Freshdouble/RFM23_Module/Coordinate.png

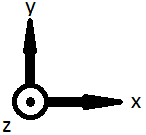
Coordinate.png
