Freshdouble/RFM23_Module/BR_BOM_Selection.xlsx

Part | Value | Package | Qty | Place_YES/NO | Povided_by_customer_YES/NO | Distributor | Ordernumber | Remarks_customer | Unit_price | Total_price | REMARKS_BETA
AE1 AE2 |  | SMA_THT | 2 | NO | YES
C10 C11 C12 C5 C6 C20 C41 C19 C31 C32 C33 C26 C27 C22 C42 C40 | 100nF | 0603 | 16 | YES | NO | Digikey | 399-7845-1-ND
C14 C13 C15 C35 C34 C36 | 47µF | 1210 | 6 | YES | NO | Digikey | 490-6538-1-ND
C16 C37 | 47pF | 0603 | 2 | YES | NO | Digikey | 399-6191-1-ND
C17 C38 | 680pF | 0603 | 2 | YES | NO | Digikey | 399-7948-1-ND
C18 C39 | 12pF | 0603 | 2 | YES | NO | Digikey | 712-1313-1-ND
C2 C23 | 1µF | 1210 | 2 | YES | NO | Digikey | 587-1366-1-ND
C3 C24 | 1nF | 0603 | 2 | YES | NO | Digikey | 478-1215-1-ND
C4 C1 C25 C21 | 10µF | 1210 | 4 | YES | NO | Digikey | 490-1875-1-ND
C7 C8 C28 C29 | 15pF | 0603 | 4 | YES | NO | Digikey | 478-6024-1-ND
C9 C30 | 10nF | 0603 | 2 | YES | NO | Digikey | 478-1227-1-ND
CON11 CON21 | FTS-130-03-L-DV-SA | FTS-130-03-L-DV-SA | 2 | YES | NO | Digikey | FTS-130-03-L-DV-SA-ND | Place on Toplayer
CON11 CON21 | CLP-130-02-F-D-A | CLP-130-02-F-D-A | 2 | YES | NO | Digikey | CLP-130-02-F-D-A-ND | Place on Bottomlayer
D10 D28 | DZ2J036M0L | SOD-323F | 2 | YES | NO | Digikey | DZ2J036M0LCT-ND
D11 D12 D13 D14 D15 D16 D17 D18 D33 | SMF3.3 | SOD-123F | 9 | NO | YES | Digikey | F7701CT-ND
D9 D4 D1 D2 D6 D3 D5 D8 D7 D30 D29 D27 D22 D19 D20 D24 D21 D23 D26 D25 D32 D31 | TS4148C RZG | 0603 | 22 | YES | NO | Digikey | TS4148C RZGCT-ND
L1 L3 | 10nH | 0603 | 2 | YES | NO | Digikey | 1276-6306-1-ND
L2 L4 | 5µH | L_6.3x6.3_H3 | 2 | YES | NO | Digikey | 308-2073-2-ND
Q1 Q9 | SSM3J334R,LF | SOT-23 | 2 | NO | NO | Digikey | SSM3J334RLFTR-ND
Q2 Q17 Q10 Q18 | AO3414 | SOT-23 | 4 | YES | NO | Digikey | 785-1009-1-ND
Q6 Q7 Q3 Q4 Q5 Q8 Q14 Q15 Q11 Q12 Q13 Q16 | MMBT5551-TP | SOT-23 | 12 | YES | NO | Digikey | MMBT5551-TPTR-ND
R1 R46 | 22k | 0603 | 2 | YES | NO | Digikey | RMCF0603JT22K0CT-ND
R10 R55 | 15k | 0603 | 2 | YES | NO | Digikey | RMCF0603JT15K0CT-ND
R14 R11 R6 R2 R9 R3 R7 R92 R59 R56 R51 R47 R54 R48 R52 R96 | 100k | 0603 | 16 | YES | NO | Digikey | 311-100KLDCT-ND
R15 R16 | 0R | 0805 | 2 | NO | YES
R18 R5 R91 R63 R50 R95 | 100R | 0603 | 6 | YES | NO | Digikey | RMCF0603JT100RCT-ND
R20 R26 R27 R28 R29 R30 R45 R76 R71 R72 R73 R74 R75 R77 | 4k7 | 0603 | 14 | YES | NO | Digikey | 311-4.7KGRCT-ND
R36 R84 | 90k9 | 0603 | 2 | YES | NO | Digikey | P90.9KHCT-ND
R37 R85 | 49k9 | 0603 | 2 | YES | NO | Digikey | RMCF0603FT49K9CT-ND
R38 R86 | 6k81 | 0603 | 2 | YES | NO | Digikey | RMCF0603FT6K81CT-ND
R39 R87 | 121k | 0603 | 2 | YES | NO | Digikey | 311-2410-1-ND
R4 R49 | 47R | 0603 | 2 | YES | NO | Digikey | RMCF0603JT47R0CT-ND
R40 R88 | 887k | 0603 | 2 | YES | NO | Digikey | P16016CT-ND
R43 R83 | 0R | 0603 | 2 | YES | NO | Digikey | P0.0GCT-ND
R8 R12 R13 R93 R94 R19 R21 R22 R23 R24 R25 R31 R32 R33 R34 R35 R42 R41 R44 R53 R57 R58 R97 R98 R69 R64 R65 R66 R67 R68 R78 R79 R80 R81 R82 R90 R89 R70 | 10k | 0603 | 38 | YES | NO | Digikey | RMCF0603JT10K0CT-ND
U1 U6 | MC74HC4538ADR2G | SOIC16 | 2 | YES | NO | Digikey | MC74HC4538ADR2GOSCT-ND
U2 U7 | MAX892LEUA+ | µMax8 | 2 | YES | NO | Digikey | MAX892LEUA+-ND
U3 U8 | ATMEGA128-16AURCT-ND | TQFP64 | 2 | YES | NO | Digikey | ATMEGA128-16AURCT-ND
U4 U9 | LTC3113IFE#PBF | TSSOP 20 | 2 | YES | NO | Digikey | LTC3113IFE#PBF-ND
U5 U10 |  | RFM23BP | 2 | NO | YES
Y1 Y2 |  | Crystal_SMD_7050-4pin_7.0x5.0mm | 2 | YES | NO | Digikey | 535-9825-1-ND
