Freshdouble/RFM23_Module/cubesatFunkmodul-all.ods

name | X-axis | Y-axis | angle | value | package | side
FID1 | 69.7995 | -107.6115 | 0.0000 | Fiducial | Fiducial_0.5mm_Dia_1mm_Outer | top
FID2 | 121.8695 | -108.5005 | 0.0000 | Fiducial | Fiducial_0.5mm_Dia_1mm_Outer | top
FID3 | 96.2155 | -40.3015 | 0.0000 | Fiducial | Fiducial_0.5mm_Dia_1mm_Outer | top
FID4 | 91.8975 | -114.4695 | 0.0000 | Fiducial | Fiducial_0.5mm_Dia_1mm_Outer | bottom
FID5 | 59.0045 | -48.8105 | 0.0000 | Fiducial | Fiducial_0.5mm_Dia_1mm_Outer | bottom
FID6 | 127.8385 | -42.9685 | 0.0000 | Fiducial | Fiducial_0.5mm_Dia_1mm_Outer | bottom
C3 | 70.0151 | -106.3463 | 180.0000 | 1nF | C_0603_HandSoldering | bottom
C6 | 80.5942 | -97.5814 | 0.0000 | 100nF | C_0603_HandSoldering | bottom
C13 | 64.2026 | -37.6657 | 0.0000 | 47µF | C_1210_HandSoldering | bottom
C14 | 71.4162 | -37.6149 | 0.0000 | 47µF | C_1210_HandSoldering | bottom
C15 | 69.0641 | -41.1404 | 0.0000 | 47µF | C_1210_HandSoldering | bottom
C16 | 71.8388 | -49.6498 | 270.0000 | 47pF | C_0603_HandSoldering | bottom
C17 | 70.7441 | -56.1116 | 180.0000 | 680pF | C_0603_HandSoldering | bottom
C18 | 71.8007 | -53.3201 | 90.0000 | 12pF | C_0603_HandSoldering | bottom
C19 | 83.6523 | -37.7876 | 180.0000 | 100nF | C_0603_HandSoldering | bottom
C20 | 66.2051 | -114.3473 | 270.0000 | 100nF | C_0603_HandSoldering | bottom
C22 | 125.4125 | -115.6843 | 180.0000 | 100nF | C_0603_HandSoldering | bottom
C24 | 130.2766 | -108.9152 | 90.0000 | 1nF | C_0603_HandSoldering | bottom
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
U8 | 113.6396 | -98.3996 | 270.0000 | ATMEGA128-16AU | TQFP-64_14x14mm_Pitch0.8mm | top
Y1 | 63.5545 | -96.8765 | 0.0000 | 407F39D007M3728 | Crystal_SMD_7050-4pin_7.0x5.0mm | top
Y2 | 99.5045 | -97.9265 | 90.0000 | 407F39D007M3728 | Crystal_SMD_7050-4pin_7.0x5.0mm | top
