Freshdouble/RFM23_Module/(threads)

Thread 1 (2018-02-08):

False pins for AO3414

Freshdouble, 2018-02-08:
FET: Q2, Q10, Q17, Q18
have false schematic pin mapping

Freshdouble, 2018-02-08:
Footprint doesn't match actual device footprint.

Footprint on PCB SOT23
Device Footprint SOT23W

Thread 2 (2018-02-08):

False pin mapping for SSM3J334RLFTR

Freshdouble, 2018-02-08:
FET Q1 and Q9 have false pin mapping in schematic

Freshdouble, 2018-02-08:
Footprint doesn't match actual device footprint.

Footprint on PCB SOT23
Device Footprint SOT23F
