Freshdouble/RFM23_Module/BestückungsplanBottom.pdf

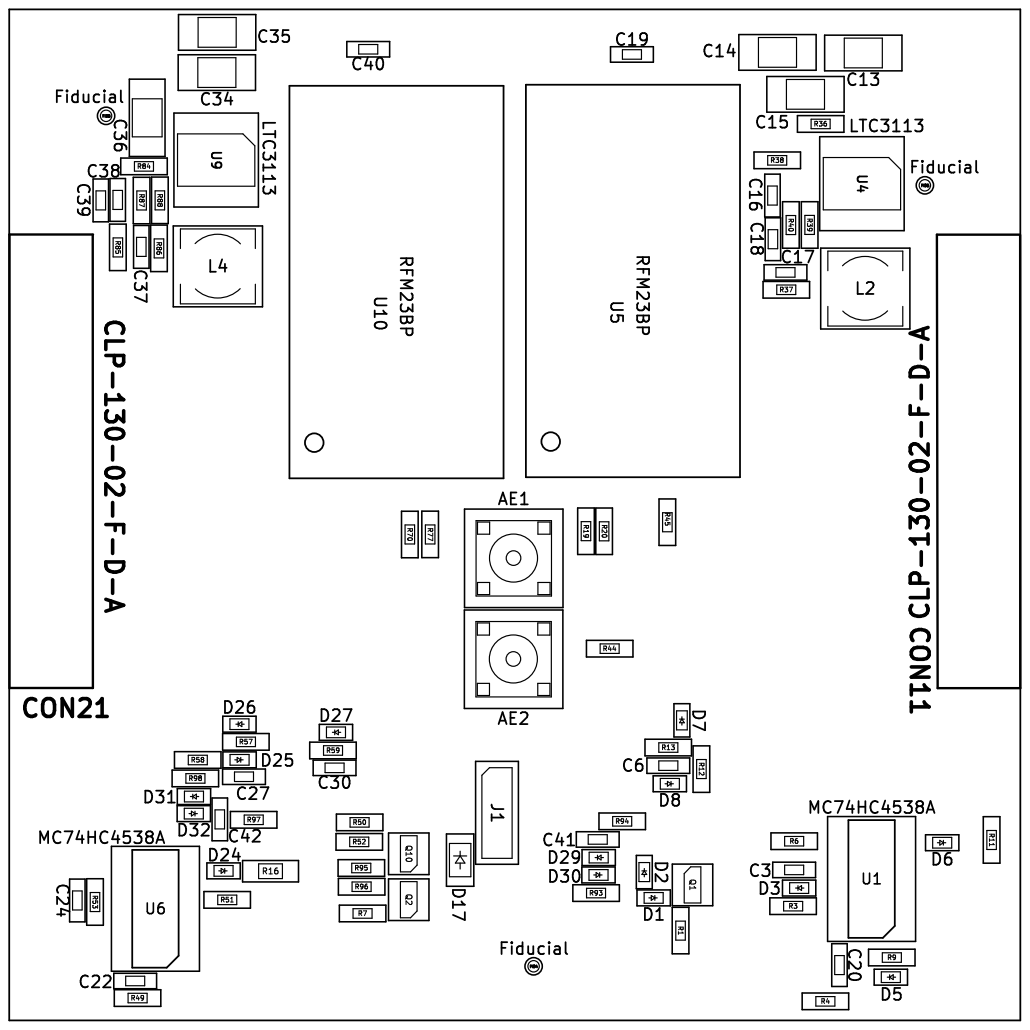
[picture p2: page 1]
