Freshdouble/RFM23_Module/BestückungsplanTop.pdf

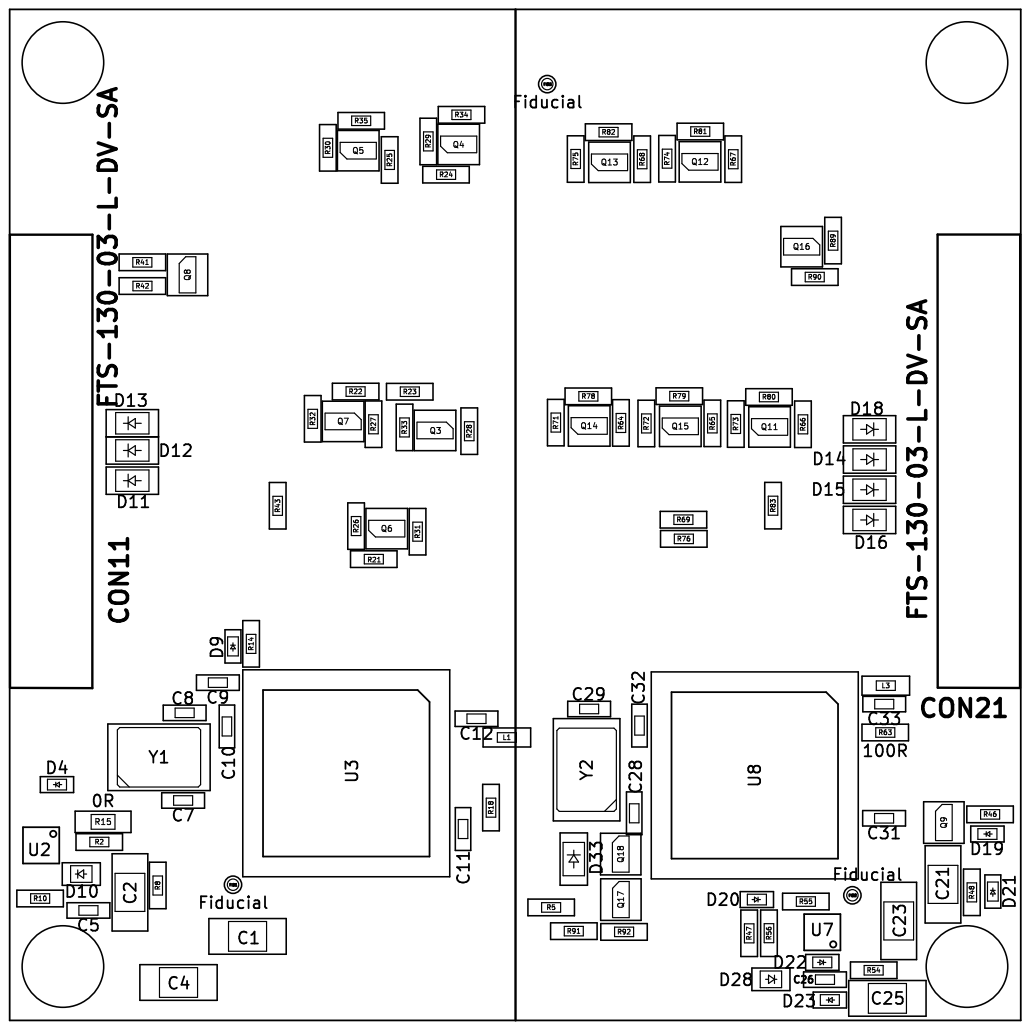
[picture p3: page 1]
