Freshdouble/RFM23_Module/Bestückung/cubesatFunkmodul-F.CrtYd.pdf

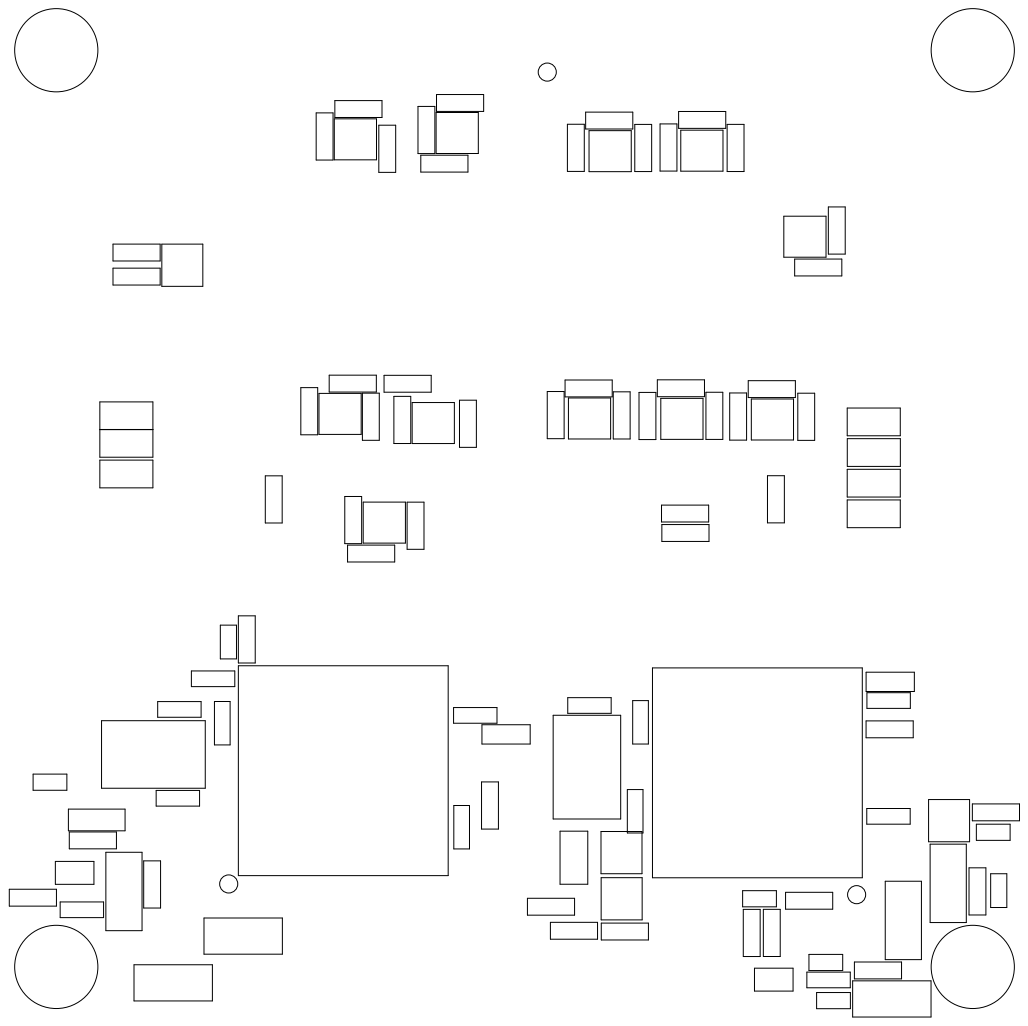
[picture p4: page 1]
