Freshdouble/RFM23_Module/Bestückung/cubesatFunkmodul-F.Fab.pdf

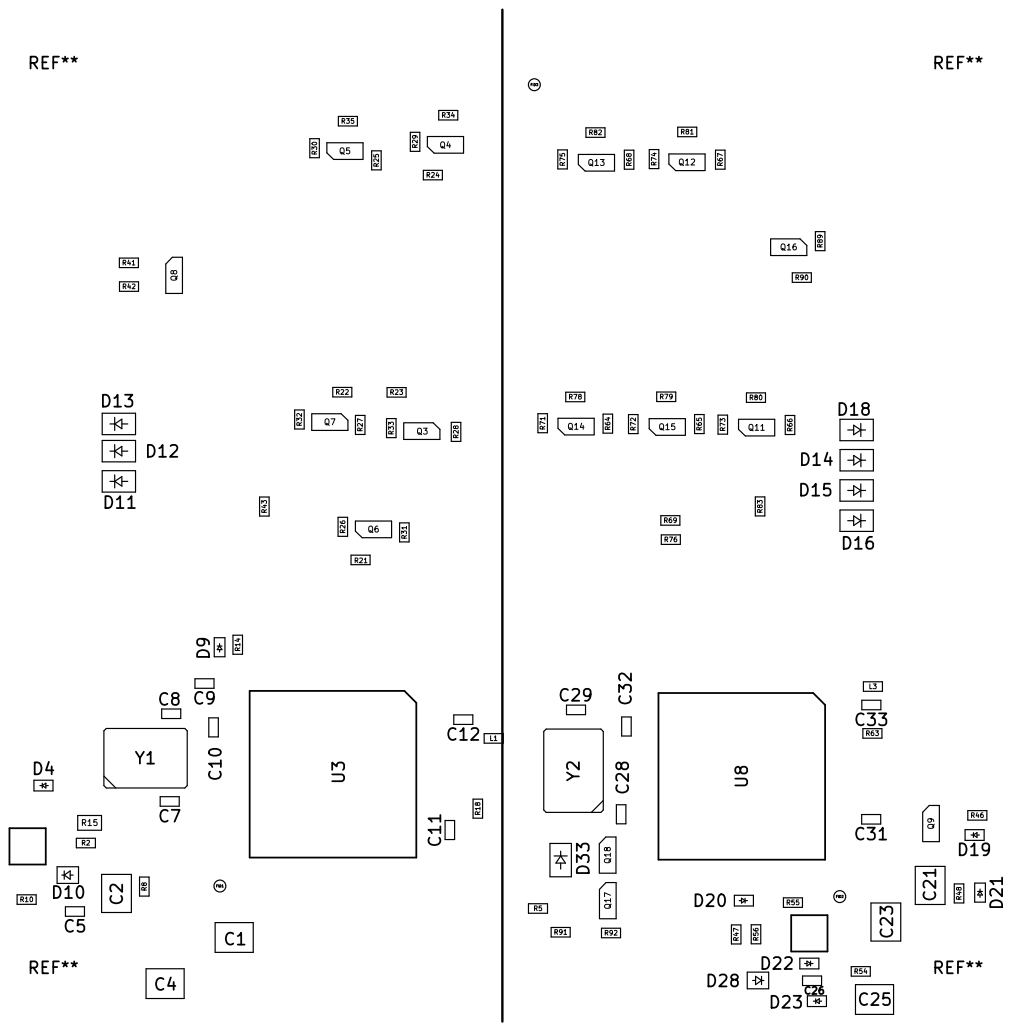
[picture p5: page 1]
