Freshdouble/RFM23_Module/cubesatFunkmodul.kicad_pcb

## KiCad design cubesatFunkmodul.kicad_pcb (2019-05-15)

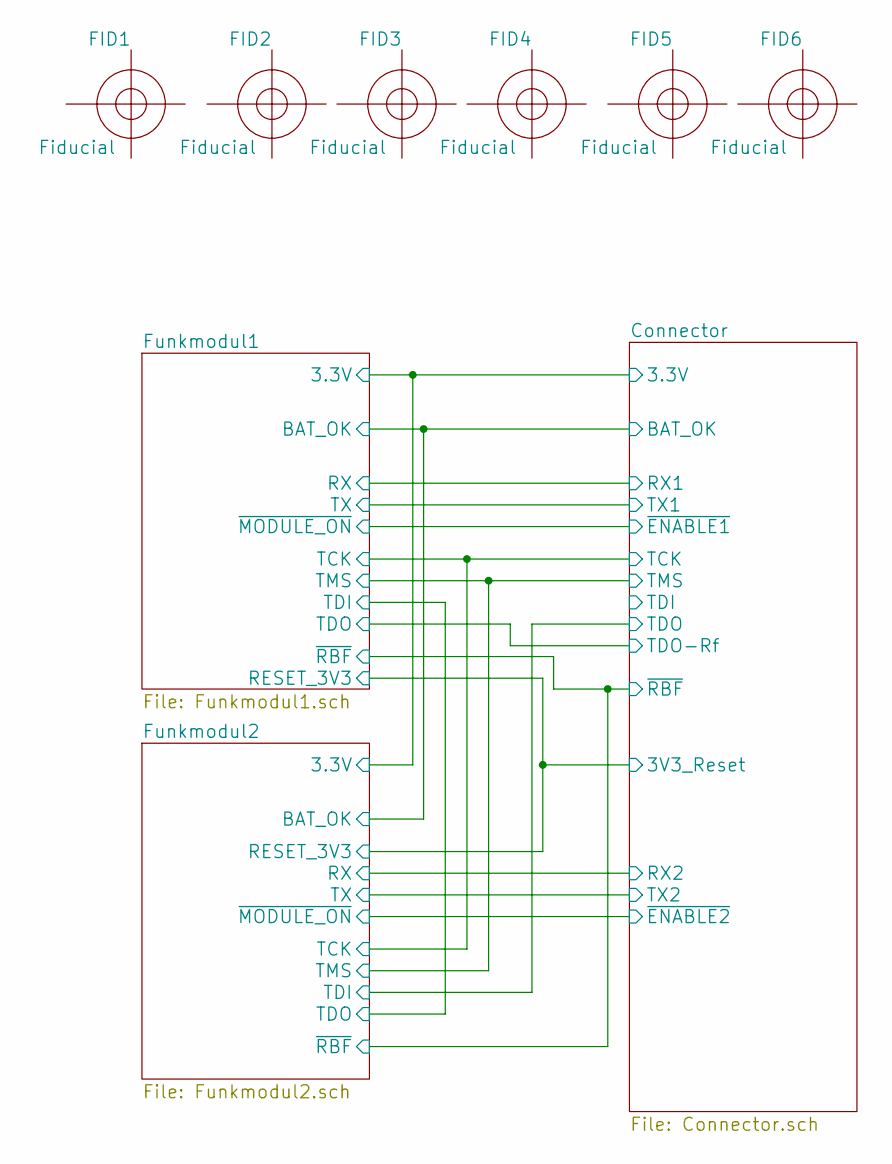
[picture p6: schematic cubesatFunkmodul.sch]

Parts:
FID1, FID2, FID3, FID4, FID5, FID6: Fiducial; Fiducial_0.5mm_Dia_1mm_Outer

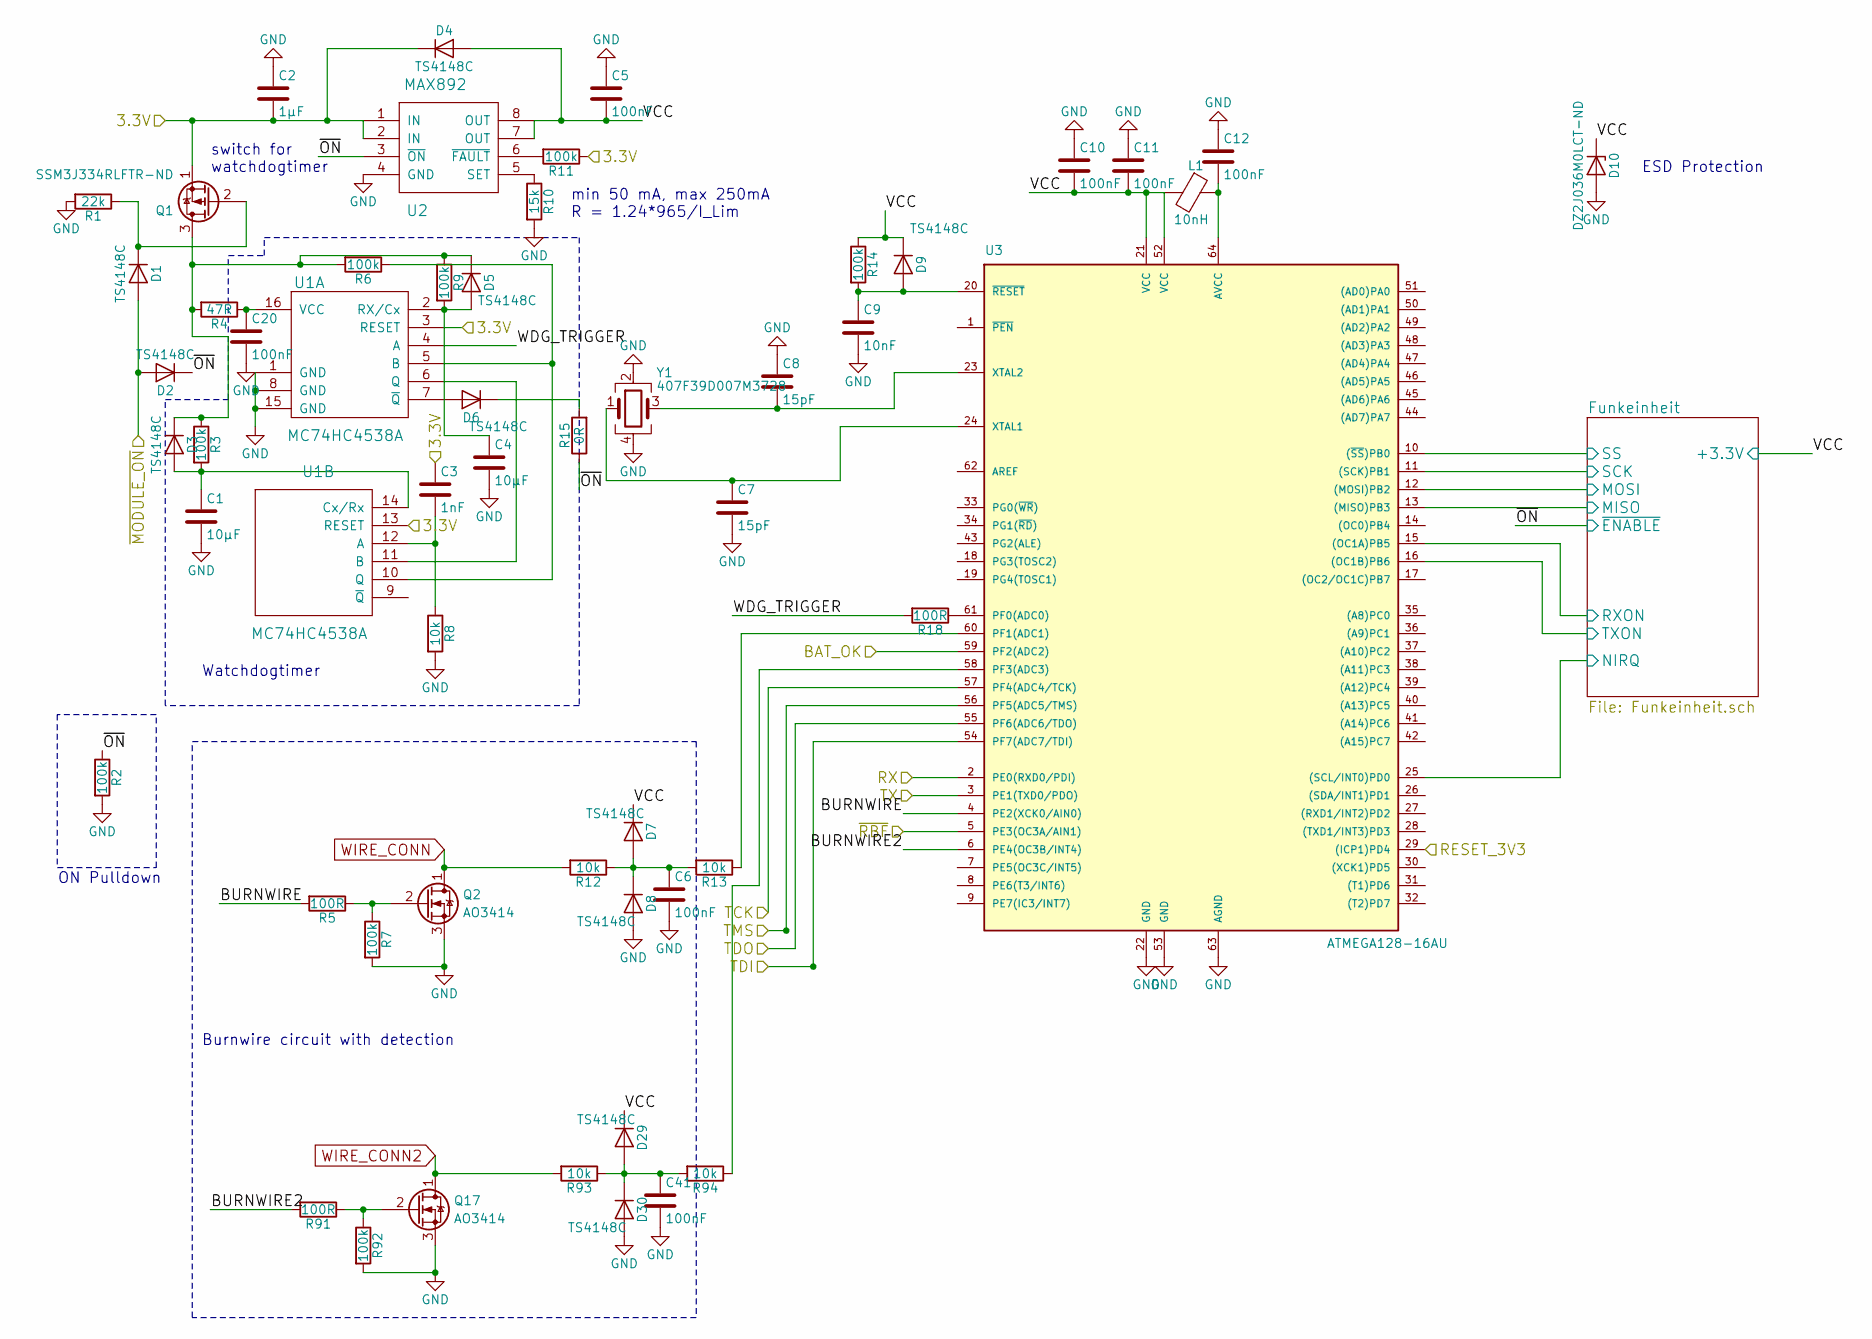
[picture p7: schematic Funkmodul1.sch]

Parts:
C1, C4: 10µF; C_1210_HandSoldering
C2: 1µF; C_1210_HandSoldering
C3: 1nF; C_0603_HandSoldering
C5, C6, C10, C11, C12, C20, C41: 100nF; C_0603_HandSoldering
C7, C8: 15pF; C_0603_HandSoldering
C9: 10nF; C_0603_HandSoldering
D1, D2, D3, D4, D5, D6, D7, D8, D9, D29, D30: TS4148C; D_0603
D10: DZ2J036M0LCT-ND; D_SOD-323F
L1: 10nH; L_0603_HandSoldering
Q1: SSM3J334RLFTR-ND; SOT-23
Q2, Q17: AO3414; SOT-23
R1: 22k; R_0603_HandSoldering
R2, R3, R6, R7, R9, R11, R14, R92: 100k; R_0603_HandSoldering
R4: 47R; R_0603_HandSoldering
R5, R18, R91: 100R; R_0603_HandSoldering
R8, R12, R13, R93, R94: 10k; R_0603_HandSoldering
R10: 15k; R_0603_HandSoldering
R15: 0R; R_0805_HandSoldering
U1: MC74HC4538A; SOIC-16_3.9x9.9mm_Pitch1.27mm
U2: MAX892; µMAX-8
U3: ATMEGA128-16AU; TQFP-64_14x14mm_Pitch0.8mm
Y1: 407F39D007M3728; Crystal_SMD_7050-4pin_7.0x5.0mm

Connections:
/Connector/3.3V: C2.2, C3.1, D4.1 (K), Q1.1 (S), R11.1, U1.3 (RESET), U1.13 (RESET), U2.1 (IN), U2.2 (IN); also elsewhere on the board
/Connector/3V3_Reset: U3.29 ((ICP1)PD4); also elsewhere on the board
/Connector/BAT_OK: U3.59 (PF2(ADC2)); also elsewhere on the board
/Connector/TCK: U3.57 (PF4(ADC4/TCK)); also elsewhere on the board
/Connector/TMS: U3.56 (PF5(ADC5/TMS)); also elsewhere on the board
/Connector/~ENABLE1~: D1.2 (A), D2.2 (A); also elsewhere on the board
/Connector/~RBF~: U3.5 (PE3(OC3A/AIN1)); also elsewhere on the board
/Funkmodul1/BURNWIRE: R5.2, U3.4 (PE2(XCK0/AIN0))
/Funkmodul1/BURNWIRE2: R91.2, U3.6 (PE4(OC3B/INT4))
/Funkmodul1/Funkeinheit/MISO: U3.13 ((MISO)PB3); also elsewhere on the board
/Funkmodul1/Funkeinheit/MOSI: U3.12 ((MOSI)PB2); also elsewhere on the board
/Funkmodul1/Funkeinheit/NIRQ: U3.25 ((SCL/INT0)PD0); also elsewhere on the board
/Funkmodul1/Funkeinheit/RXON: U3.15 ((OC1A)PB5); also elsewhere on the board
/Funkmodul1/Funkeinheit/SCK: U3.11 ((SCK)PB1); also elsewhere on the board
/Funkmodul1/Funkeinheit/SS: U3.10 ((~SS~)PB0); also elsewhere on the board
/Funkmodul1/Funkeinheit/TXON: U3.16 ((OC1B)PB6); also elsewhere on the board
/Funkmodul1/RX: U3.2 (PE0(RXD0/PDI)); also elsewhere on the board
/Funkmodul1/TDI: U3.54 (PF7(ADC7/TDI)); also elsewhere on the board
/Funkmodul1/TDO: U3.55 (PF6(ADC6/TDO)); also elsewhere on the board
/Funkmodul1/TX: U3.3 (PE1(TXD0/PDO)); also elsewhere on the board
/Funkmodul1/VCC: C5.2, C10.2, C11.2, D4.2 (A), D7.1 (K), D9.1 (K), D10.1 (K), D29.1 (K), L1.2, R14.1, U2.7 (OUT), U2.8 (OUT), U3.21 (VCC), U3.52 (VCC); also elsewhere on the board
/Funkmodul1/WDG_TRIGGER: R18.2, U1.4 (A)
/Funkmodul1/~ON~: D2.1 (K), R2.1, R15.1, U2.3 (~ON~); also elsewhere on the board
GND: C1.2, C2.1, C4.2, C5.1, C6.2, C7.2, C8.1, C9.2, C10.1, C11.1, C12.1, C20.2, C41.2, D8.2 (A), D10.2 (A), D30.2 (A), Q2.3 (S), Q17.3 (S), R1.2, R2.2, R7.2, R8.2, R10.2, R92.2, U1.1 (GND), U1.8 (GND), U1.15 (GND), U2.4 (GND), U3.22 (GND), U3.53 (GND), U3.63 (AGND), Y1.2, Y1.4; also elsewhere on the board
unnamed: C1.1, D3.2 (A), R3.2, U1.14 (Cx/Rx)
unnamed: C3.2, R8.1, U1.12 (A)
unnamed: C4.1, D5.2 (A), R9.2, U1.2 (RX/Cx)
unnamed: C6.1, D7.2 (A), D8.1 (K), R12.1, R13.2
unnamed: C7.1, U3.24 (XTAL1), Y1.1
unnamed: C8.2, U3.23 (XTAL2), Y1.3
unnamed: C9.1, D9.2 (A), R14.2, U3.20 (~RESET)
unnamed: C12.2, L1.1, U3.64 (AVCC)
unnamed: C20.1, R4.1, U1.16 (VCC)
unnamed: C41.1, D29.2 (A), D30.1 (K), R93.1, R94.2
unnamed: D1.1 (K), Q1.2 (G), R1.1
unnamed: D3.1 (K), D5.1 (K), Q1.3 (D), R3.1, R4.2, R6.2, R9.1
unnamed: D6.1 (K), R15.2
unnamed: D6.2 (A), U1.7 (~Q~)
unnamed: Q2.2 (G), R5.1, R7.1
unnamed: Q17.2 (G), R91.1, R92.1
unnamed: R6.1, U1.5 (B), U1.10 (Q)
unnamed: R10.1, U2.5 (SET)
unnamed: R11.2, U2.6 (~FAULT~)
unnamed: R13.1, U3.60 (PF1(ADC1))
unnamed: R18.1, U3.61 (PF0(ADC0))
unnamed: R94.1, U3.58 (PF3(ADC3))
unnamed: U1.6 (Q), U1.11 (B)
WIRE_CONN: Q2.1 (D), R12.2; also elsewhere on the board
WIRE_CONN2: Q17.1 (D), R93.2; also elsewhere on the board

Notes on the sheet:
min 50 mA, max 250mA R = 1.24*965/I_Lim
Burnwire circuit with detection
Watchdogtimer
switch for watchdogtimer
ON Pulldown
ESD Protection

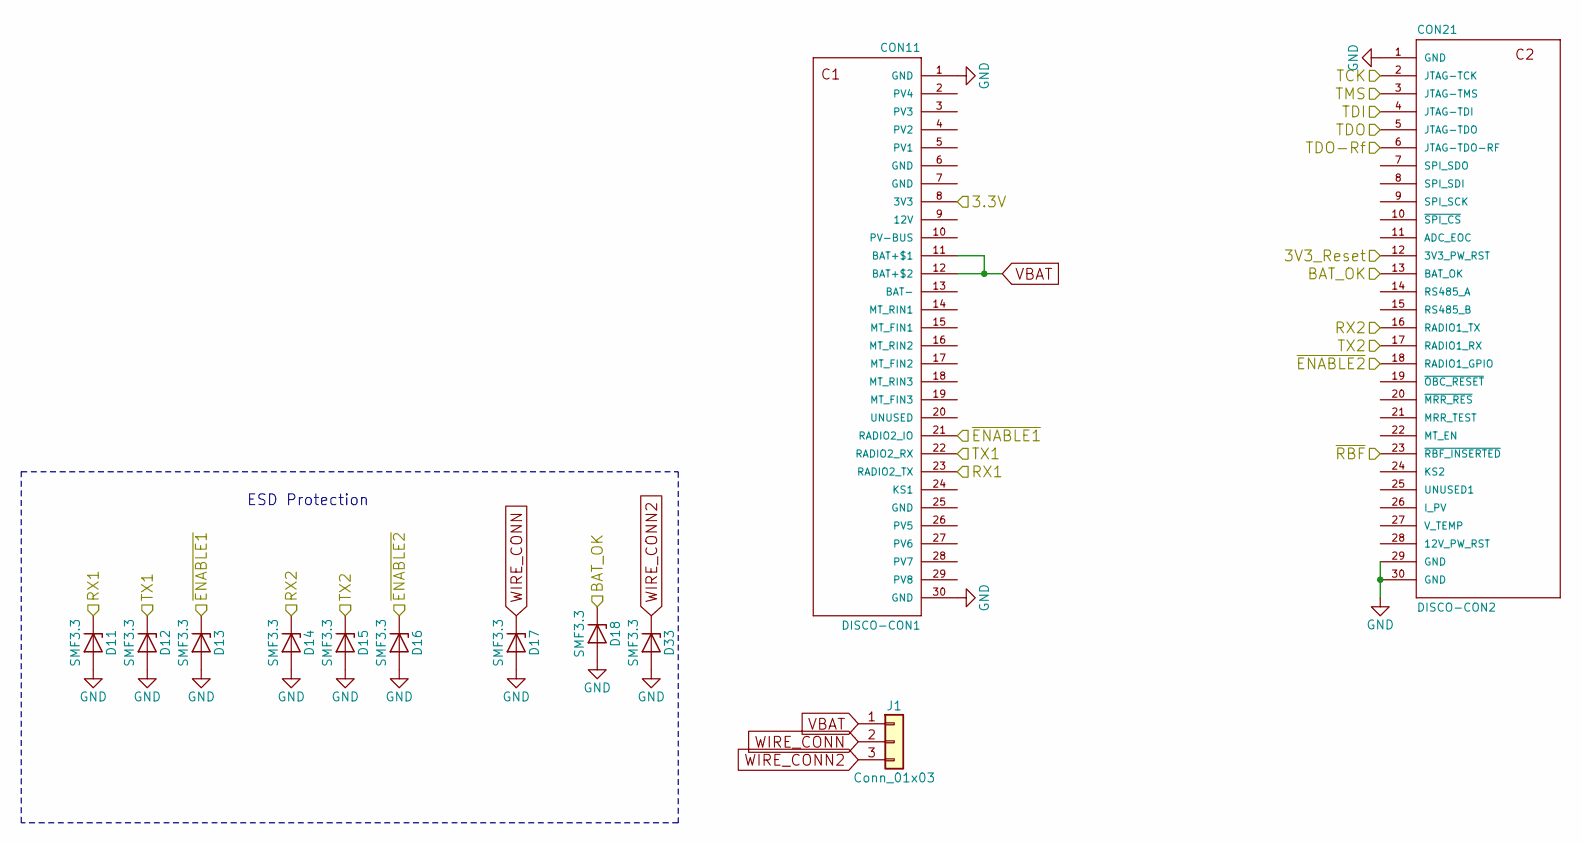
[picture p8: schematic Connector.sch]

Parts:
CON11: DISCO-CON1; Cubesatconnector
CON21: DISCO-CON2; Cubesatconnector
D11, D12, D13, D14, D15, D16, D17, D18, D33: SMF3.3; D_SOD-123F
J1: Conn_01x03; Pin_Header_Straight_1x03_Pitch2.54mm

Connections:
/Connector/3.3V: CON11.8 (3V3); also elsewhere on the board
/Connector/3V3_Reset: CON21.12 (3V3_PW_RST); also elsewhere on the board
/Connector/BAT_OK: CON21.13 (BAT_OK), D18.1 (K); also elsewhere on the board
/Connector/TCK: CON21.2 (JTAG-TCK); also elsewhere on the board
/Connector/TDI: CON21.4 (JTAG-TDI)
/Connector/TMS: CON21.3 (JTAG-TMS); also elsewhere on the board
/Connector/~ENABLE1~: CON11.21 (RADIO2_IO), D13.1 (K); also elsewhere on the board
/Connector/~ENABLE2~: CON21.18 (RADIO1_GPIO), D16.1 (K); also elsewhere on the board
/Connector/~RBF~: CON21.23 (~RBF_INSERTED); also elsewhere on the board
/Funkmodul1/RX: CON11.23 (RADIO2_TX), D11.1 (K); also elsewhere on the board
/Funkmodul1/TDO: CON21.6 (JTAG-TDO-RF); also elsewhere on the board
/Funkmodul1/TX: CON11.22 (RADIO2_RX), D12.1 (K); also elsewhere on the board
/Funkmodul2/RX: CON21.16 (RADIO1_TX), D14.1 (K); also elsewhere on the board
/Funkmodul2/TDI: CON21.5 (JTAG-TDO); also elsewhere on the board
/Funkmodul2/TX: CON21.17 (RADIO1_RX), D15.1 (K); also elsewhere on the board
GND: CON11.1 (GND), CON11.30 (GND), CON21.1 (GND), CON21.29 (GND), CON21.30 (GND), D11.2 (A), D12.2 (A), D13.2 (A), D14.2 (A), D15.2 (A), D16.2 (A), D17.2 (A), D18.2 (A), D33.2 (A); also elsewhere on the board
VBAT: CON11.11 (BAT+$1), CON11.12 (BAT+$2), J1.1; also elsewhere on the board
WIRE_CONN: D17.1 (K), J1.2; also elsewhere on the board
WIRE_CONN2: D33.1 (K), J1.3; also elsewhere on the board

Notes on the sheet:
ESD Protection

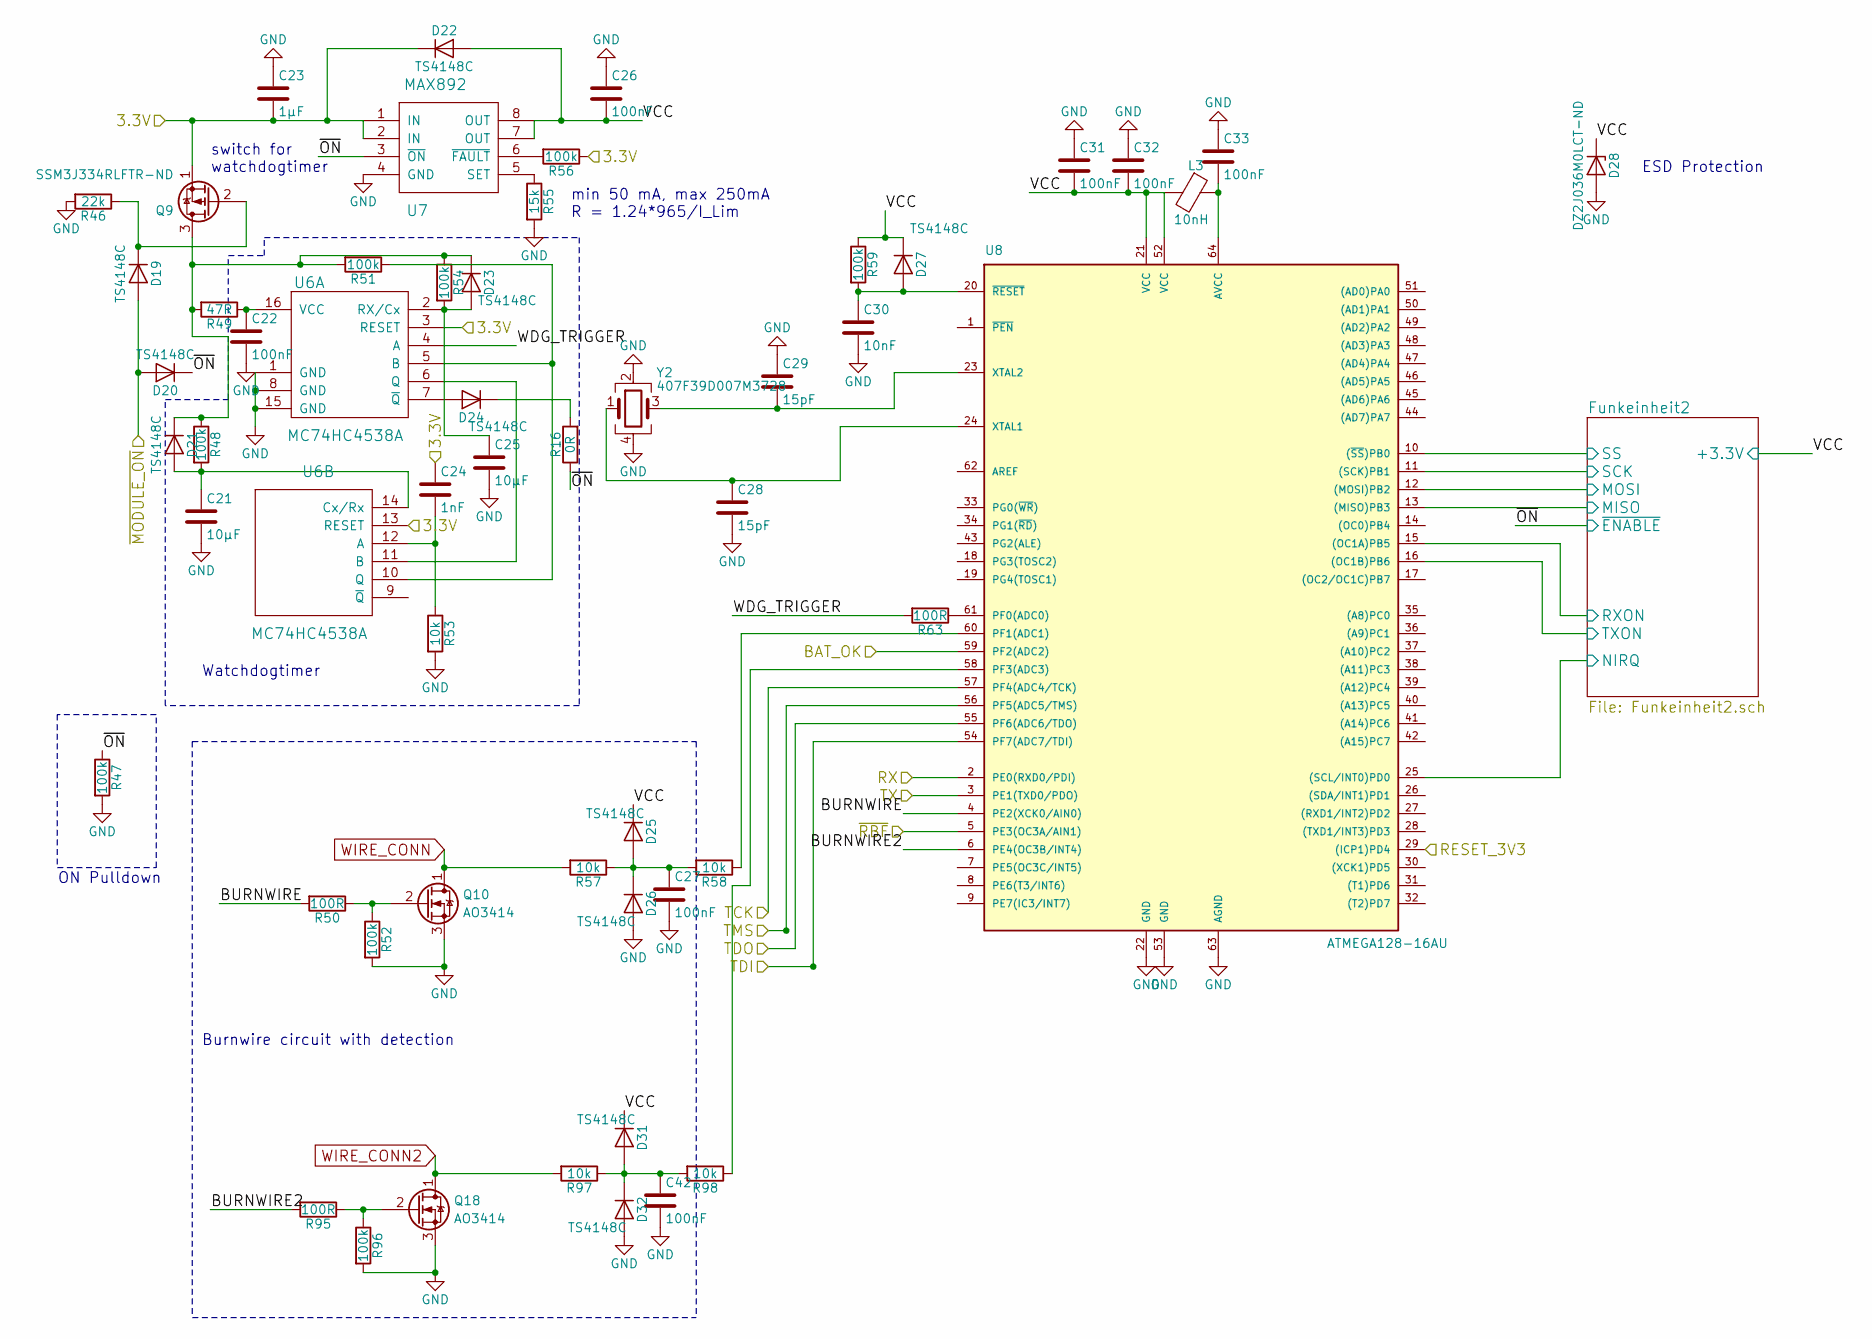
[picture p9: schematic Funkmodul2.sch]

Parts:
C21, C25: 10µF; C_1210_HandSoldering
C22, C26, C27, C31, C32, C33, C42: 100nF; C_0603_HandSoldering
C23: 1µF; C_1210_HandSoldering
C24: 1nF; C_0603_HandSoldering
C28, C29: 15pF; C_0603_HandSoldering
C30: 10nF; C_0603_HandSoldering
D19, D20, D21, D22, D23, D24, D25, D26, D27, D31, D32: TS4148C; D_0603
D28: DZ2J036M0LCT-ND; D_SOD-323F
L3: 10nH; L_0603_HandSoldering
Q9: SSM3J334RLFTR-ND; SOT-23
Q10, Q18: AO3414; SOT-23
R16: 0R; R_0805_HandSoldering
R46: 22k; R_0603_HandSoldering
R47, R48, R51, R52, R54, R56, R59, R96: 100k; R_0603_HandSoldering
R49: 47R; R_0603_HandSoldering
R50, R63, R95: 100R; R_0603_HandSoldering
R53, R57, R58, R97, R98: 10k; R_0603_HandSoldering
R55: 15k; R_0603_HandSoldering
U6: MC74HC4538A; SOIC-16_3.9x9.9mm_Pitch1.27mm
U7: MAX892; µMAX-8
U8: ATMEGA128-16AU; TQFP-64_14x14mm_Pitch0.8mm
Y2: 407F39D007M3728; Crystal_SMD_7050-4pin_7.0x5.0mm

Connections:
/Connector/3.3V: C23.2, C24.1, D22.1 (K), Q9.1 (S), R56.1, U6.3 (RESET), U6.13 (RESET), U7.1 (IN), U7.2 (IN); also elsewhere on the board
/Connector/3V3_Reset: U8.29 ((ICP1)PD4); also elsewhere on the board
/Connector/BAT_OK: U8.59 (PF2(ADC2)); also elsewhere on the board
/Connector/TCK: U8.57 (PF4(ADC4/TCK)); also elsewhere on the board
/Connector/TMS: U8.56 (PF5(ADC5/TMS)); also elsewhere on the board
/Connector/~ENABLE2~: D19.2 (A), D20.2 (A); also elsewhere on the board
/Connector/~RBF~: U8.5 (PE3(OC3A/AIN1)); also elsewhere on the board
/Funkmodul1/TDI: U8.55 (PF6(ADC6/TDO)); also elsewhere on the board
/Funkmodul2/BURNWIRE: R50.2, U8.4 (PE2(XCK0/AIN0))
/Funkmodul2/BURNWIRE2: R95.2, U8.6 (PE4(OC3B/INT4))
/Funkmodul2/Funkeinheit2/MISO: U8.13 ((MISO)PB3); also elsewhere on the board
/Funkmodul2/Funkeinheit2/MOSI: U8.12 ((MOSI)PB2); also elsewhere on the board
/Funkmodul2/Funkeinheit2/NIRQ: U8.25 ((SCL/INT0)PD0); also elsewhere on the board
/Funkmodul2/Funkeinheit2/RXON: U8.15 ((OC1A)PB5); also elsewhere on the board
/Funkmodul2/Funkeinheit2/SCK: U8.11 ((SCK)PB1); also elsewhere on the board
/Funkmodul2/Funkeinheit2/SS: U8.10 ((~SS~)PB0); also elsewhere on the board
/Funkmodul2/Funkeinheit2/TXON: U8.16 ((OC1B)PB6); also elsewhere on the board
/Funkmodul2/RX: U8.2 (PE0(RXD0/PDI)); also elsewhere on the board
/Funkmodul2/TDI: U8.54 (PF7(ADC7/TDI)); also elsewhere on the board
/Funkmodul2/TX: U8.3 (PE1(TXD0/PDO)); also elsewhere on the board
/Funkmodul2/VCC: C26.2, C31.2, C32.2, D22.2 (A), D25.1 (K), D27.1 (K), D28.1 (K), D31.1 (K), L3.2, R59.1, U7.7 (OUT), U7.8 (OUT), U8.21 (VCC), U8.52 (VCC); also elsewhere on the board
/Funkmodul2/WDG_TRIGGER: R63.2, U6.4 (A)
/Funkmodul2/~ON~: D20.1 (K), R16.1, R47.1, U7.3 (~ON~); also elsewhere on the board
GND: C21.2, C22.2, C23.1, C25.2, C26.1, C27.2, C28.2, C29.1, C30.2, C31.1, C32.1, C33.1, C42.2, D26.2 (A), D28.2 (A), D32.2 (A), Q10.3 (S), Q18.3 (S), R46.2, R47.2, R52.2, R53.2, R55.2, R96.2, U6.1 (GND), U6.8 (GND), U6.15 (GND), U7.4 (GND), U8.22 (GND), U8.53 (GND), U8.63 (AGND), Y2.2, Y2.4; also elsewhere on the board
unnamed: C21.1, D21.2 (A), R48.2, U6.14 (Cx/Rx)
unnamed: C22.1, R49.1, U6.16 (VCC)
unnamed: C24.2, R53.1, U6.12 (A)
unnamed: C25.1, D23.2 (A), R54.2, U6.2 (RX/Cx)
unnamed: C27.1, D25.2 (A), D26.1 (K), R57.1, R58.2
unnamed: C28.1, U8.24 (XTAL1), Y2.1
unnamed: C29.2, U8.23 (XTAL2), Y2.3
unnamed: C30.1, D27.2 (A), R59.2, U8.20 (~RESET)
unnamed: C33.2, L3.1, U8.64 (AVCC)
unnamed: C42.1, D31.2 (A), D32.1 (K), R97.1, R98.2
unnamed: D19.1 (K), Q9.2 (G), R46.1
unnamed: D21.1 (K), D23.1 (K), Q9.3 (D), R48.1, R49.2, R51.2, R54.1
unnamed: D24.1 (K), R16.2
unnamed: D24.2 (A), U6.7 (~Q~)
unnamed: Q10.2 (G), R50.1, R52.1
unnamed: Q18.2 (G), R95.1, R96.1
unnamed: R51.1, U6.5 (B), U6.10 (Q)
unnamed: R55.1, U7.5 (SET)
unnamed: R56.2, U7.6 (~FAULT~)
unnamed: R58.1, U8.60 (PF1(ADC1))
unnamed: R63.1, U8.61 (PF0(ADC0))
unnamed: R98.1, U8.58 (PF3(ADC3))
unnamed: U6.6 (Q), U6.11 (B)
WIRE_CONN: Q10.1 (D), R57.2; also elsewhere on the board
WIRE_CONN2: Q18.1 (D), R97.2; also elsewhere on the board

Notes on the sheet:
min 50 mA, max 250mA R = 1.24*965/I_Lim
Burnwire circuit with detection
Watchdogtimer
switch for watchdogtimer
ON Pulldown
ESD Protection

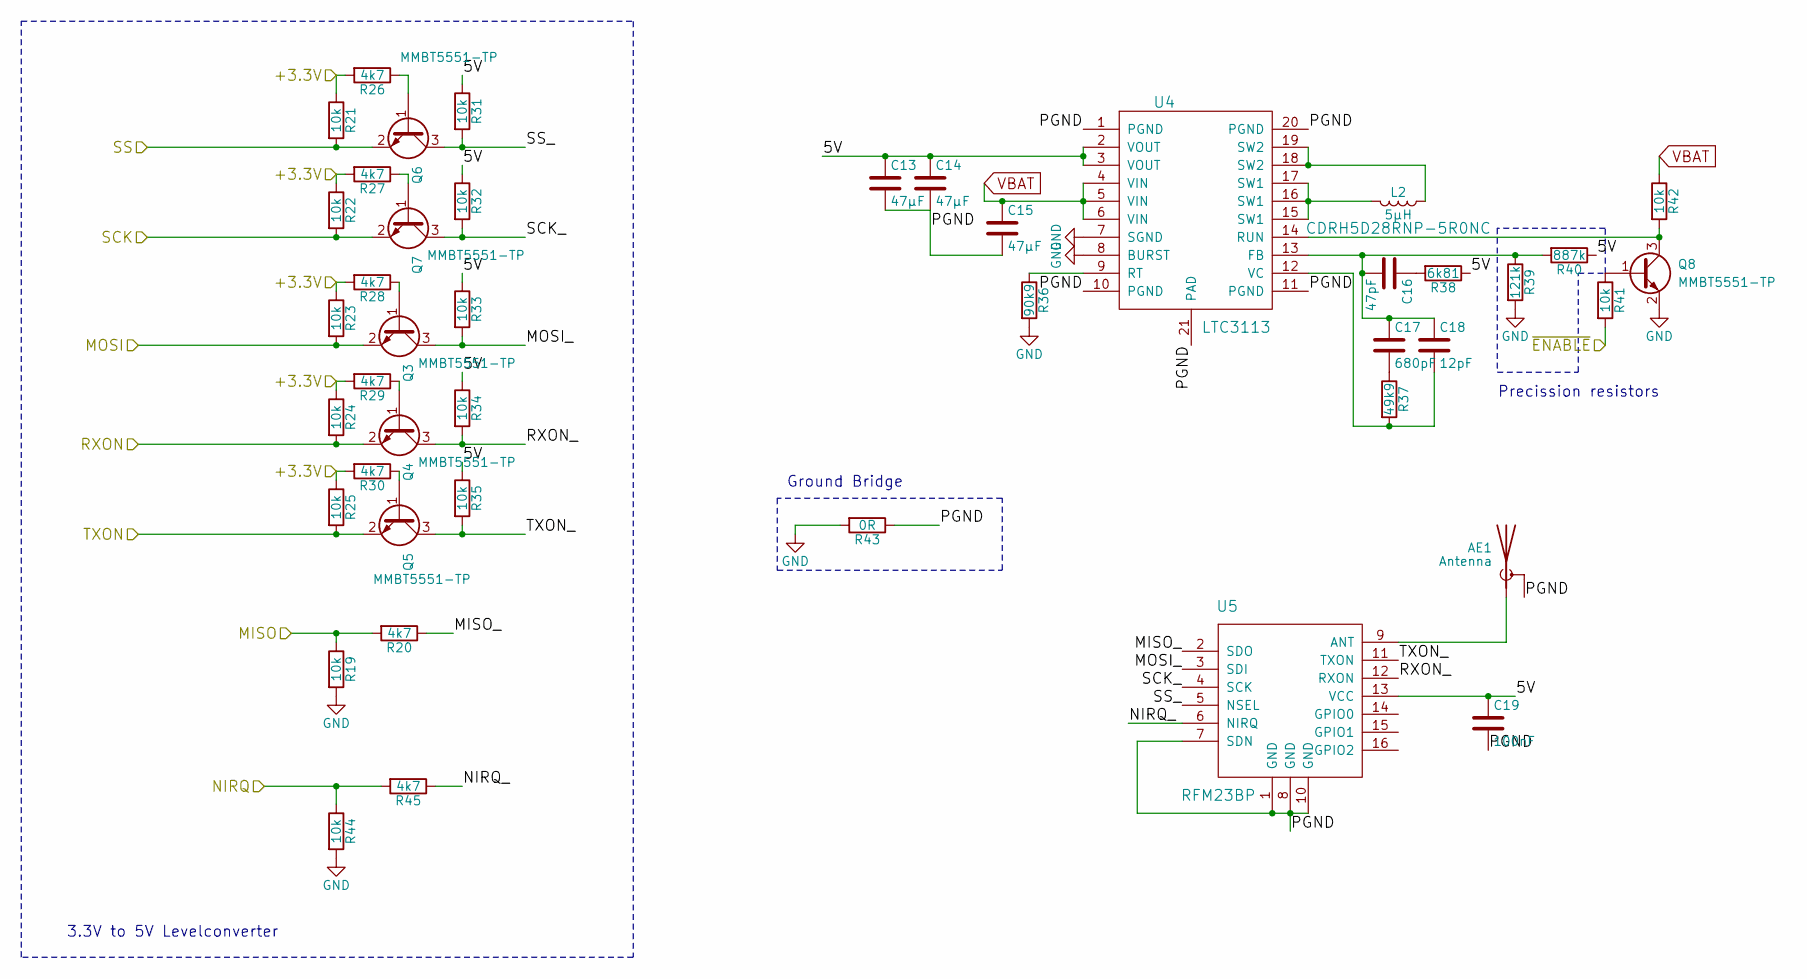
[picture p10: schematic Funkeinheit.sch]

Parts:
AE1: Antenna; SMA_THT_Jack_Straight
C13, C14, C15: 47µF; C_1210_HandSoldering
C16: 47pF; C_0603_HandSoldering
C17: 680pF; C_0603_HandSoldering
C18: 12pF; C_0603_HandSoldering
C19: 100nF; C_0603_HandSoldering
L2: 5µH; L_6.3x6.3_H3
Q3, Q4, Q5, Q6, Q7, Q8: MMBT5551-TP; SOT-23
R19, R21, R22, R23, R24, R25, R31, R32, R33, R34, R35, R41, R42, R44: 10k; R_0603_HandSoldering
R20, R26, R27, R28, R29, R30, R45: 4k7; R_0603_HandSoldering
R36: 90k9; R_0603_HandSoldering
R37: 49k9; R_0603_HandSoldering
R38: 6k81; R_0603_HandSoldering
R39: 121k; R_0603_HandSoldering
R40: 887k; R_0603_HandSoldering
R43: 0R; R_0603_HandSoldering
U4: LTC3113; HTSSOP-20-1EP_4.4x6.5mm_Pitch0.65mm_ThermalPad
U5: RFM23BP

Connections:
/Funkmodul1/Funkeinheit/5V: C13.1, C14.1, C19.1, R31.1, R32.1, R33.1, R34.1, R35.1, R38.1, R40.1, U4.2 (VOUT), U4.3 (VOUT), U5.13 (VCC)
/Funkmodul1/Funkeinheit/MISO: R19.1, R20.2; also elsewhere on the board
/Funkmodul1/Funkeinheit/MISO_: R20.1, U5.2 (SDO)
/Funkmodul1/Funkeinheit/MOSI: Q3.2 (E), R23.2; also elsewhere on the board
/Funkmodul1/Funkeinheit/MOSI_: Q3.3 (C), R33.2, U5.3 (SDI)
/Funkmodul1/Funkeinheit/NIRQ: R44.1, R45.2; also elsewhere on the board
/Funkmodul1/Funkeinheit/NIRQ_: R45.1, U5.6 (NIRQ)
/Funkmodul1/Funkeinheit/PGND: AE1.2 (Shield), C13.2, C14.2, C15.2, C19.2, R43.1, U4.1 (PGND), U4.10 (PGND), U4.11 (PGND), U4.20 (PGND), U4.21 (PAD), U5.1 (GND), U5.7 (SDN), U5.8 (GND), U5.10 (GND)
/Funkmodul1/Funkeinheit/RXON: Q4.2 (E), R24.2; also elsewhere on the board
/Funkmodul1/Funkeinheit/RXON_: Q4.3 (C), R34.2, U5.12 (RXON)
/Funkmodul1/Funkeinheit/SCK: Q7.2 (E), R22.2; also elsewhere on the board
/Funkmodul1/Funkeinheit/SCK_: Q7.3 (C), R32.2, U5.4 (SCK)
/Funkmodul1/Funkeinheit/SS: Q6.2 (E), R21.2; also elsewhere on the board
/Funkmodul1/Funkeinheit/SS_: Q6.3 (C), R31.2, U5.5 (NSEL)
/Funkmodul1/Funkeinheit/TXON: Q5.2 (E), R25.2; also elsewhere on the board
/Funkmodul1/Funkeinheit/TXON_: Q5.3 (C), R35.2, U5.11 (TXON)
/Funkmodul1/VCC: R21.1, R22.1, R23.1, R24.1, R25.1, R26.2, R27.2, R28.2, R29.2, R30.2; also elsewhere on the board
/Funkmodul1/~ON~: R41.2; also elsewhere on the board
GND: Q8.2 (E), R19.2, R36.2, R39.2, R43.2, R44.2, U4.7 (SGND), U4.8 (BURST); also elsewhere on the board
unnamed: AE1.1 (A), U5.9 (ANT)
unnamed: C16.1, R38.2
unnamed: C16.2, C17.1, C18.1, R39.1, R40.2, U4.13 (FB)
unnamed: C17.2, R37.1
unnamed: C18.2, R37.2, U4.12 (VC)
unnamed: L2.1, U4.18 (SW2), U4.19 (SW2)
unnamed: L2.2, U4.15 (SW1), U4.16 (SW1), U4.17 (SW1)
unnamed: Q3.1 (B), R28.1
unnamed: Q4.1 (B), R29.1
unnamed: Q5.1 (B), R30.1
unnamed: Q6.1 (B), R26.1
unnamed: Q7.1 (B), R27.1
unnamed: Q8.1 (B), R41.1
unnamed: Q8.3 (C), R42.2, U4.14 (RUN)
unnamed: R36.1, U4.9 (RT)
VBAT: C15.1, R42.1, U4.4 (VIN), U4.5 (VIN), U4.6 (VIN); also elsewhere on the board

Notes on the sheet:
Ground Bridge
Precission resistors
3.3V to 5V Levelconverter

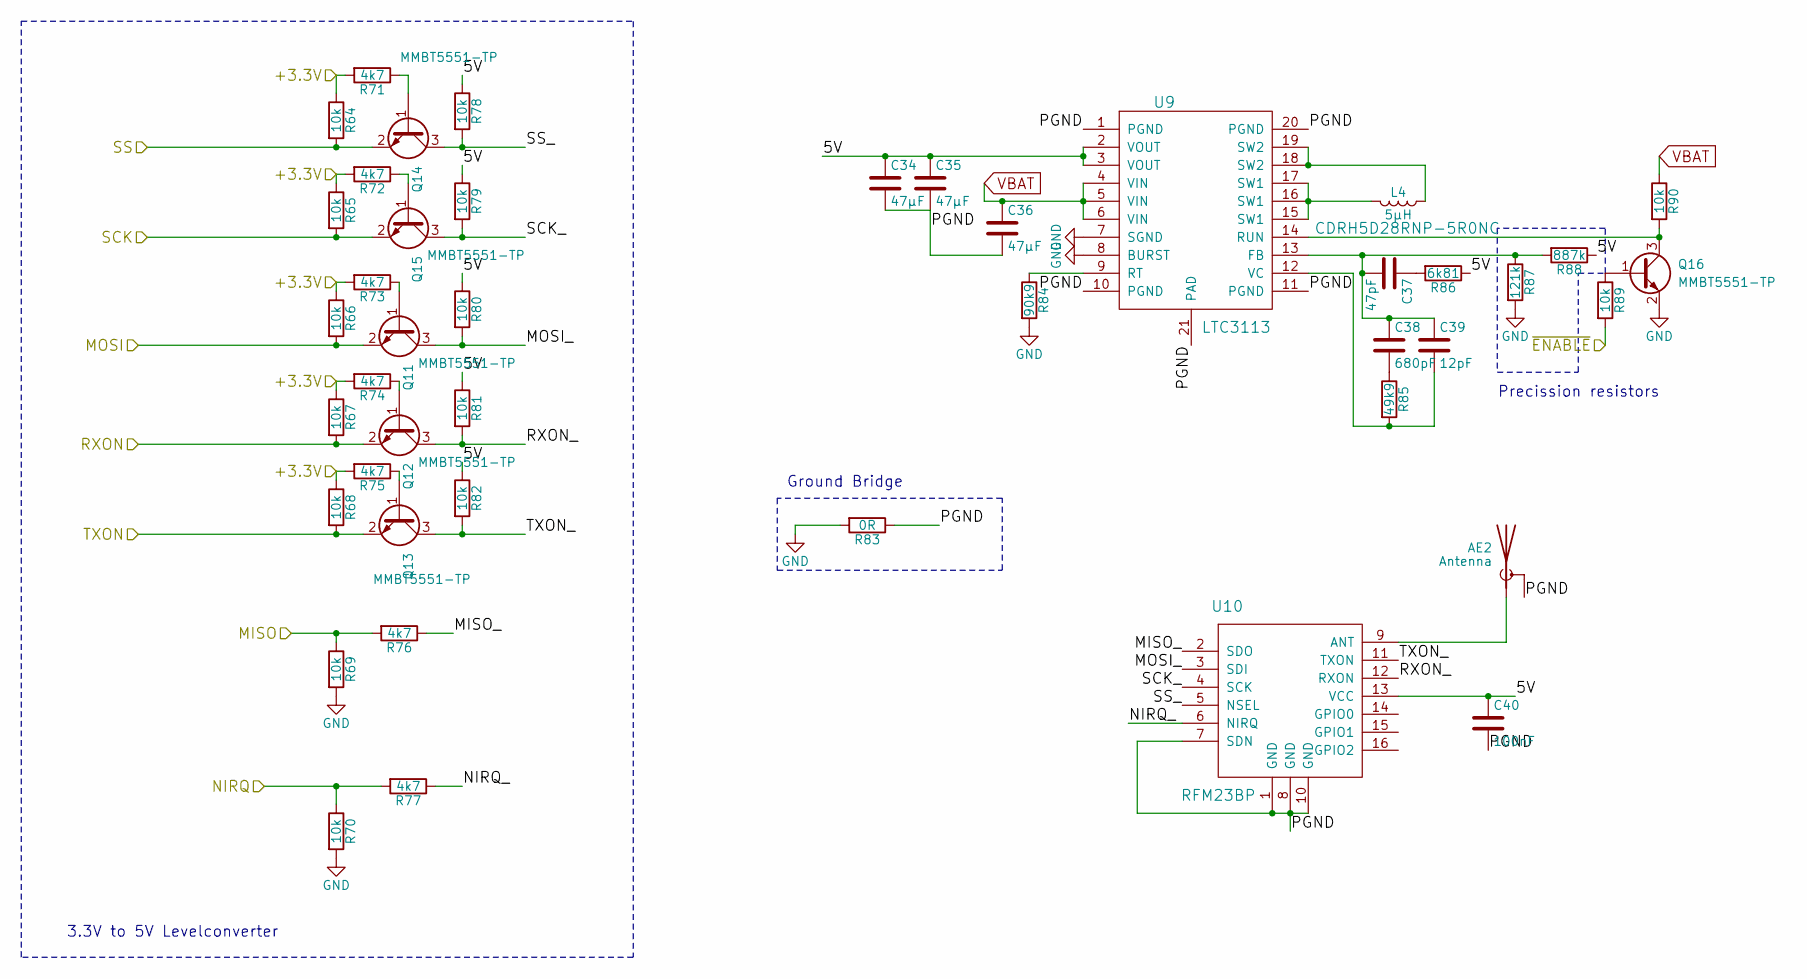
[picture p11: schematic Funkeinheit2.sch]

Parts:
AE2: Antenna; SMA_THT_Jack_Straight
C34, C35, C36: 47µF; C_1210_HandSoldering
C37: 47pF; C_0603_HandSoldering
C38: 680pF; C_0603_HandSoldering
C39: 12pF; C_0603_HandSoldering
C40: 100nF; C_0603_HandSoldering
L4: 5µH; L_6.3x6.3_H3
Q11, Q12, Q13, Q14, Q15, Q16: MMBT5551-TP; SOT-23
R64, R65, R66, R67, R68, R69, R70, R78, R79, R80, R81, R82, R89, R90: 10k; R_0603_HandSoldering
R71, R72, R73, R74, R75, R76, R77: 4k7; R_0603_HandSoldering
R83: 0R; R_0603_HandSoldering
R84: 90k9; R_0603_HandSoldering
R85: 49k9; R_0603_HandSoldering
R86: 6k81; R_0603_HandSoldering
R87: 121k; R_0603_HandSoldering
R88: 887k; R_0603_HandSoldering
U9: LTC3113; HTSSOP-20-1EP_4.4x6.5mm_Pitch0.65mm_ThermalPad
U10: RFM23BP

Connections:
/Funkmodul2/Funkeinheit2/5V: C34.1, C35.1, C40.1, R78.1, R79.1, R80.1, R81.1, R82.1, R86.1, R88.1, U9.2 (VOUT), U9.3 (VOUT), U10.13 (VCC)
/Funkmodul2/Funkeinheit2/MISO: R69.1, R76.2; also elsewhere on the board
/Funkmodul2/Funkeinheit2/MISO_: R76.1, U10.2 (SDO)
/Funkmodul2/Funkeinheit2/MOSI: Q11.2 (E), R66.2; also elsewhere on the board
/Funkmodul2/Funkeinheit2/MOSI_: Q11.3 (C), R80.2, U10.3 (SDI)
/Funkmodul2/Funkeinheit2/NIRQ: R70.1, R77.2; also elsewhere on the board
/Funkmodul2/Funkeinheit2/NIRQ_: R77.1, U10.6 (NIRQ)
/Funkmodul2/Funkeinheit2/PGND: AE2.2 (Shield), C34.2, C35.2, C36.2, C40.2, R83.1, U9.1 (PGND), U9.10 (PGND), U9.11 (PGND), U9.20 (PGND), U9.21 (PAD), U10.1 (GND), U10.7 (SDN), U10.8 (GND), U10.10 (GND)
/Funkmodul2/Funkeinheit2/RXON: Q12.2 (E), R67.2; also elsewhere on the board
/Funkmodul2/Funkeinheit2/RXON_: Q12.3 (C), R81.2, U10.12 (RXON)
/Funkmodul2/Funkeinheit2/SCK: Q15.2 (E), R65.2; also elsewhere on the board
/Funkmodul2/Funkeinheit2/SCK_: Q15.3 (C), R79.2, U10.4 (SCK)
/Funkmodul2/Funkeinheit2/SS: Q14.2 (E), R64.2; also elsewhere on the board
/Funkmodul2/Funkeinheit2/SS_: Q14.3 (C), R78.2, U10.5 (NSEL)
/Funkmodul2/Funkeinheit2/TXON: Q13.2 (E), R68.2; also elsewhere on the board
/Funkmodul2/Funkeinheit2/TXON_: Q13.3 (C), R82.2, U10.11 (TXON)
/Funkmodul2/VCC: R64.1, R65.1, R66.1, R67.1, R68.1, R71.2, R72.2, R73.2, R74.2, R75.2; also elsewhere on the board
/Funkmodul2/~ON~: R89.2; also elsewhere on the board
GND: Q16.2 (E), R69.2, R70.2, R83.2, R84.2, R87.2, U9.7 (SGND), U9.8 (BURST); also elsewhere on the board
unnamed: AE2.1 (A), U10.9 (ANT)
unnamed: C37.1, R86.2
unnamed: C37.2, C38.1, C39.1, R87.1, R88.2, U9.13 (FB)
unnamed: C38.2, R85.1
unnamed: C39.2, R85.2, U9.12 (VC)
unnamed: L4.1, U9.18 (SW2), U9.19 (SW2)
unnamed: L4.2, U9.15 (SW1), U9.16 (SW1), U9.17 (SW1)
unnamed: Q11.1 (B), R73.1
unnamed: Q12.1 (B), R74.1
unnamed: Q13.1 (B), R75.1
unnamed: Q14.1 (B), R71.1
unnamed: Q15.1 (B), R72.1
unnamed: Q16.1 (B), R89.1
unnamed: Q16.3 (C), R90.2, U9.14 (RUN)
unnamed: R84.1, U9.9 (RT)
VBAT: C36.1, R90.1, U9.4 (VIN), U9.5 (VIN), U9.6 (VIN); also elsewhere on the board

Notes on the sheet:
Ground Bridge
Precission resistors
3.3V to 5V Levelconverter
