Freshdouble/RFM23_Module/cubesatFunkmodul.kicad_pcb

## KiCad design cubesatFunkmodul.kicad_pcb (continued)

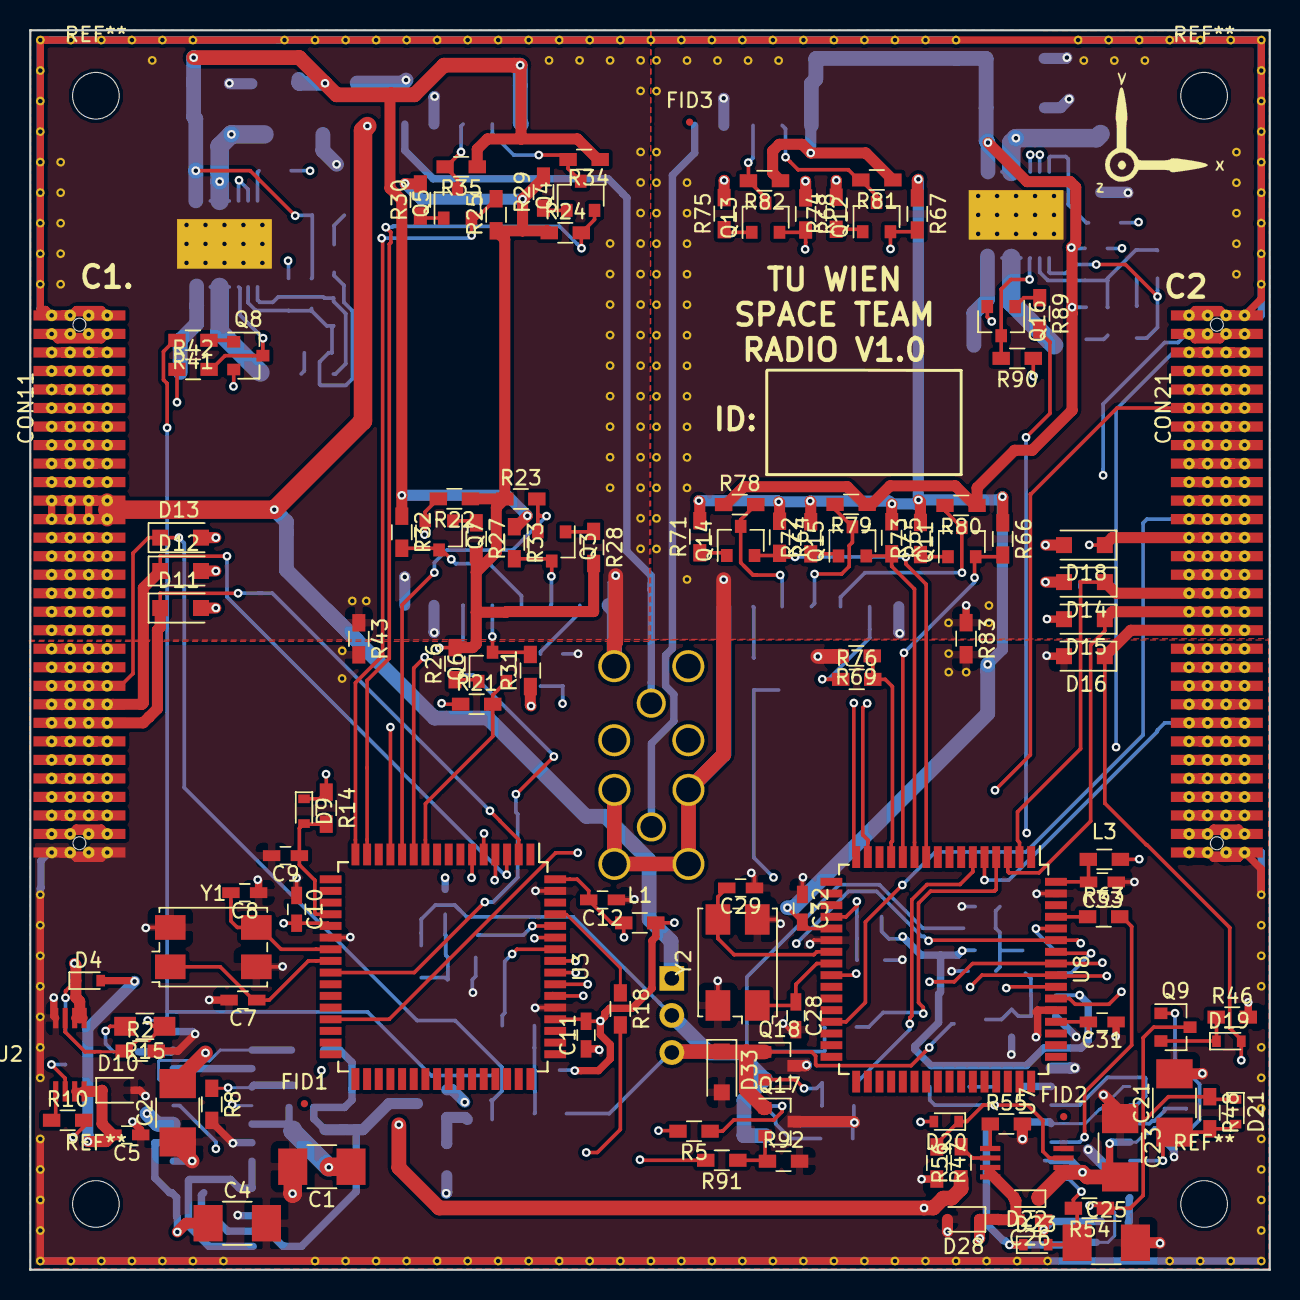
[picture p12: board cubesatFunkmodul.kicad_pcb from above]

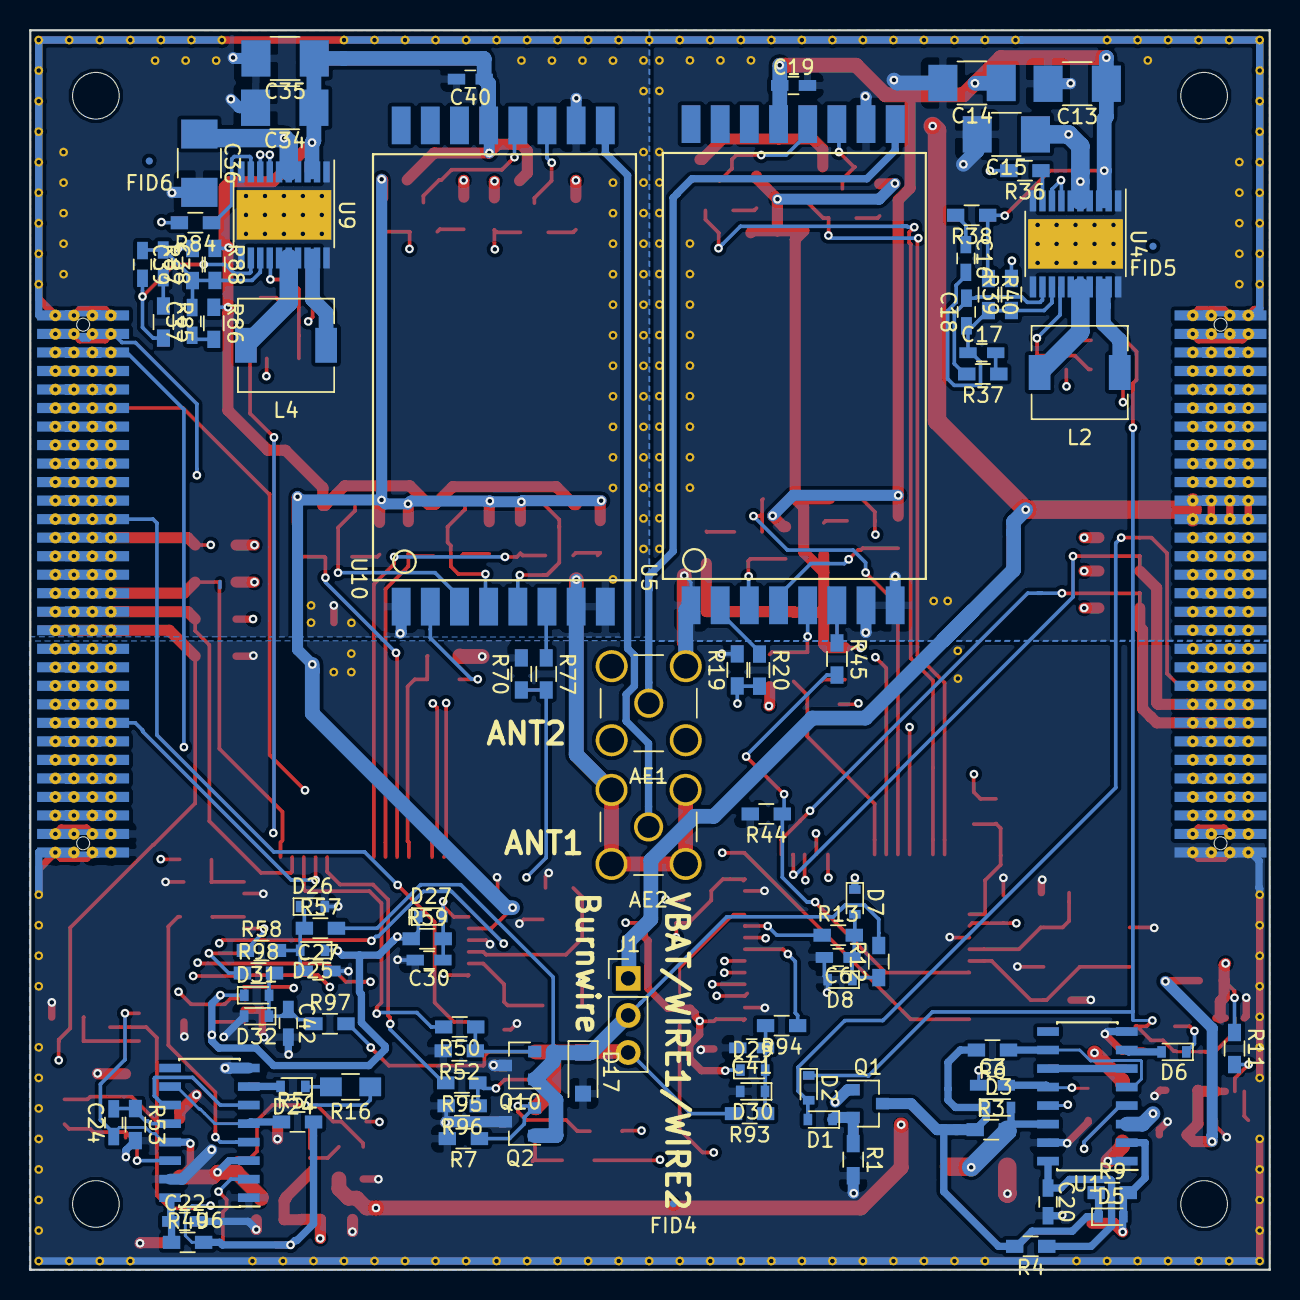
[picture p13: board cubesatFunkmodul.kicad_pcb from below]

Board: 4 copper layers, 85.0 x 85.0 mm, 214 parts (96 on the bottom side), 137 nets.
