Freshdouble/RFM23_Module/(commit log)

2017-08-15 Adds new values
    [Funkmodul1.sch, cubesatFunkmodul.sch]
2017-08-15 Cleares PCB
    [cubesatFunkmodul.kicad_pcb]
2017-08-16 Adds new submodules
    [Funkeinheit.sch, Funkmodul1.sch, cubesatFunkmodul.kicad_pcb, cubesatFunkmodul.sch]
2017-08-23 Implements stepup dc/dc
    [Funkeinheit.sch, Funkmodul1.sch, cubesatFunkmodul.sch]
2017-09-12 Adds new Modules and WDT Circuit
    - Added Schematic for MAX892 Highside Switch
    - Added Schematic for MC74HC4538A
    - Constructed Watchdogtimer Circuit to Reset µC and Radiomodule
    [Funkeinheit.sch, Funkmodul1.sch]
2017-09-20 Adds ESD Protection and finalisation of wdt
    [Connector.sch, Funkeinheit.sch, Funkmodul1.sch, cubesatFunkmodul.sch]
2017-09-23 Adds RFM23BP Module to Bib and Layout
    [Funkeinheit.sch, Funkmodul1.sch]
2017-09-25 Adds component names
    [Funkeinheit.sch, Funkmodul1.sch]
2017-10-04 Change Diodes to STTH102A
    Datasheet:
    http://www.st.com/content/ccc/resource/technical/document/datasheet/98/bc/9f/6f/26/c3/4e/73/CD00002613.pdf/files/CD00002613.pdf/jcr:content/translations/en.CD0000261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
    [Connector.sch, Funkeinheit.sch, Funkmodul1.sch, cubesatFunkmodul.sch]
2017-10-08 Auto stash before merge of "master" and "github/master"
    [Connector.sch, Funkeinheit.sch, Funkmodul1.sch, cubesatFunkmodul.sch]
2017-10-08 Adds Connectors
    [Connector.sch, Funkeinheit.sch, Funkmodul1.sch, cubesatFunkmodul.kicad_pcb, cubesatFunkmodul.sch]
2017-10-09 Adds RFM23BP Footprint and places module on board
    [Connector.sch, Funkeinheit.sch, cubesatFunkmodul.kicad_pcb]
2017-10-11 Adds Levelshifter for NIRQ
    [Connector.sch, Funkeinheit.sch, Funkmodul1.sch]
2017-10-16 Layout Module1 prefinish
    Modules Placed
    Ground Plane placed
    Supply Plane placed
    TODO: Add cubesat connector, Place Antenna connector, Place burnwire connector, Review
    [Connector.sch, Funkeinheit.sch, Funkmodul1.sch, cubesatFunkmodul.kicad_pcb, cubesatFunkmodul.sch]
2017-10-25 Adds Cubesat Connector to Layout
    [Connector.sch, Funkeinheit.sch, Funkmodul1.sch, cubesatFunkmodul.kicad_pcb, cubesatFunkmodul.sch]
2017-10-25 Replaces Q1 with p channel mosfet
    [Connector.sch, Funkeinheit.sch, Funkmodul1.sch]
2017-10-29 Resolves Bug in Cubesat Connector Library
    [Connector.sch, Funkeinheit.sch, Funkmodul1.sch, cubesatFunkmodul.kicad_pcb]
2017-11-02 Integrates Connectors in Design
    Beginn to add mounting holes
    [Connector.sch, Funkeinheit.sch, Funkmodul1.sch, cubesatFunkmodul.kicad_pcb, cubesatFunkmodul.sch]
2017-11-05 Adds new unit
    [Connector.sch, Funkeinheit2.sch, Funkmodul2.sch, cubesatFunkmodul.kicad_pcb, cubesatFunkmodul.sch]
2017-11-08 Places µC of second module
    [Connector.sch, Funkeinheit.sch, Funkeinheit2.sch, Funkmodul1.sch, Funkmodul2.sch, cubesatFunkmodul.kicad_pcb]
2017-11-13 Places all Components of second module
    [Connector.sch, Funkeinheit.sch, Funkeinheit2.sch, Funkmodul1.sch, Funkmodul2.sch, cubesatFunkmodul.kicad_pcb, cubesatFunkmodul.sch]
2017-11-13 Moved rf module to bottom layer
    [cubesatFunkmodul.kicad_pcb]
2017-11-14 Adds second burnwire fets
    [Connector.sch, Funkeinheit.sch, Funkeinheit2.sch, Funkmodul1.sch, Funkmodul2.sch, cubesatFunkmodul.kicad_pcb, cubesatFunkmodul.sch]
2017-11-15 Fixes some drc violations
    [cubesatFunkmodul.kicad_pcb]
2017-11-16 Adds SMA and Burnwire connectors
    [Connector.sch, Funkeinheit.sch, Funkeinheit2.sch, Funkmodul1.sch, Funkmodul2.sch, cubesatFunkmodul.kicad_pcb, cubesatFunkmodul.sch]
2017-11-17 Adds stiching vias
    [Connector.sch, Funkeinheit.sch, Funkeinheit2.sch, Funkmodul1.sch, Funkmodul2.sch, cubesatFunkmodul.kicad_pcb, cubesatFunkmodul.sch]
2017-11-17 Adds BOM and production files
    [Funkmodul1.sch, Funkmodul2.sch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]
2017-11-17 Adds inductor type to schematic
    [Funkeinheit.sch, Funkeinheit2.sch]
2017-11-17 Adds via for shorter ground return path
    [cubesatFunkmodul.kicad_pcb]
2017-11-17 Closes Ground Ring
    [cubesatFunkmodul-B.Cu.gbr, cubesatFunkmodul-B.Mask.gbr, cubesatFunkmodul-B.SilkS.gbr, cubesatFunkmodul-F.Cu.gbr, cubesatFunkmodul-F.Mask.gbr, cubesatFunkmodul-F.SilkS.gbr, cubesatFunkmodul-In1.Cu.gbr, cubesatFunkmodul-In2.Cu.gbr]
2017-11-20 Adds Coordinatesystem and bom selection
    [BOM_Selection.xlsx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]
2017-11-29 Places fiducial markers
    [cubesatFunkmodul.kicad_pcb]
2017-12-04 Updates BOM List
    [BOM_Selection.xlsx]
2017-12-05 Auto stash before merge of "master" and "origin/master"
    [Connector.sch, Funkeinheit.sch, Funkeinheit2.sch, Funkmodul1.sch, Funkmodul2.sch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]
2017-12-05 Adds Fiducials to pick and place data
    [cubesatFunkmodul.kicad_pcb]
2017-12-06 Formats pick and place data
    [cubesatFunkmodul-all.ods, cubesatFunkmodul.csv]
2017-12-19 Prepares top fab layer for fabricationplan output
    [cubesatFunkmodul.kicad_pcb]
2018-01-05 Bugfix for external watchdog circuit
    [Connector.sch, Funkeinheit.sch, Funkeinheit2.sch, Funkmodul1.sch, Funkmodul2.sch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]
2018-01-16 Changes to get in production
    - Adds connector outlines to component scheme
    - Changes crystalcapacitors to 15pF
    - Regenerated top and bottom component scheme
    - Adds formated BOM list for betalayout
    [BR_BOM_Selection.xlsx, Funkmodul1.sch, Funkmodul2.sch, cubesatFunkmodul.kicad_pcb]
2018-02-08 Updates pick and place file
    [cubesatFunkmodul.kicad_pcb]
2018-04-20 Adds pin connection description
    [cubesatFunkmodul.kicad_pcb]
2019-05-15 Converted to new kicad version
    [Connector-2019-03-29-17-25-05.sch, Connector-2019-05-15-11-14-13.sch, Connector.sch, Funkeinheit-2019-03-29-17-25-05.sch, Funkeinheit-2019-05-15-11-14-13.sch, Funkeinheit.sch, Funkeinheit2-2019-03-29-17-25-05.sch, Funkeinheit2-2019-05-15-11-14-13.sch]
